marionas01/Global_Resist_Electronics/README.md

This Repo contains the Schematics and PCB files for the electronic components of the EvolChip.
