marionas01/Global_Resist_Electronics/Honeywell_HSC_Pressure_Sensor/production/bom.csv

Designator | Footprint | Quantity | Value | LCSC Part #
C1 | 0603 | 1 | 0.1uF
J1 | Molex_PicoBlade_53048-0410_1x04_P1.25mm_Horizontal | 1 | Conn_01x04
R1, R2 | 0603 | 2 | 10k
SENSOR | Honeywell_HSC_SMT | 1 | Honeywell_HSC_SMT
