marionas01/Global_Resist_Electronics/Control_Board/AO3407A/AO3407A.step

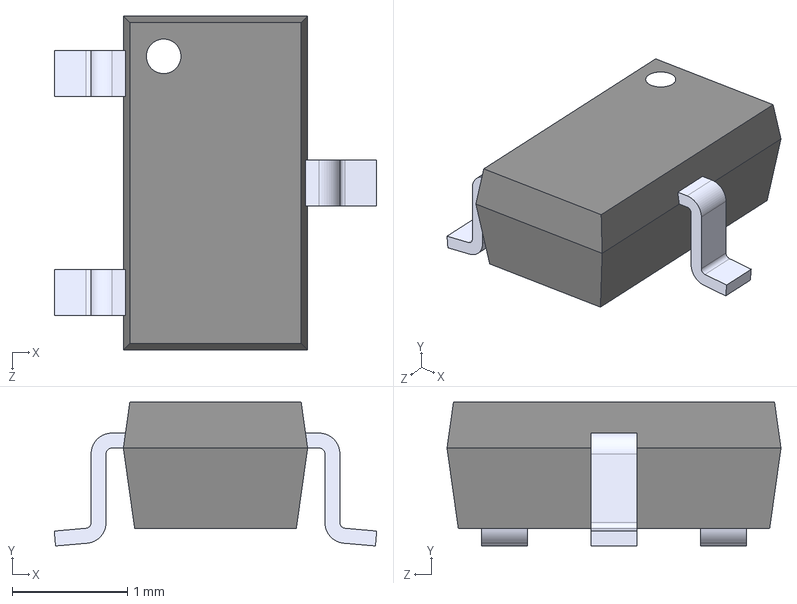
[picture p1: CAD file, 2026-08-07]
Control_Board/AO3407A/AO3407A.step
2.80 x 1.25 x 2.90 mm
