marionas01/Global_Resist_Electronics/Control_Board/CAD/MPU-9250.SLDPRT

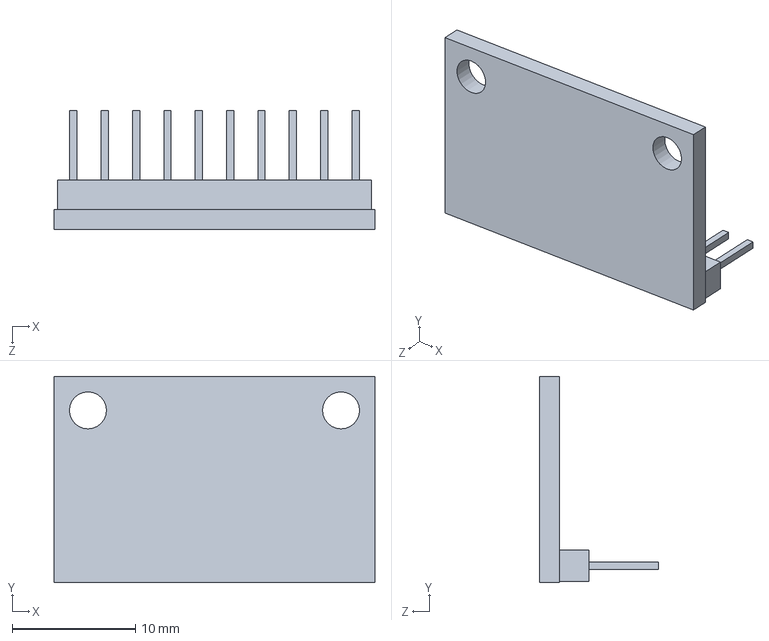
[picture p2: CAD file, 2026-11-11]
Control_Board/CAD/MPU-9250.SLDPRT
26.0 x 16.7 x 9.60 mm
