marionas01/Global_Resist_Electronics/Control_Board/TCA9406DCUR/TCA9406DCUR.step

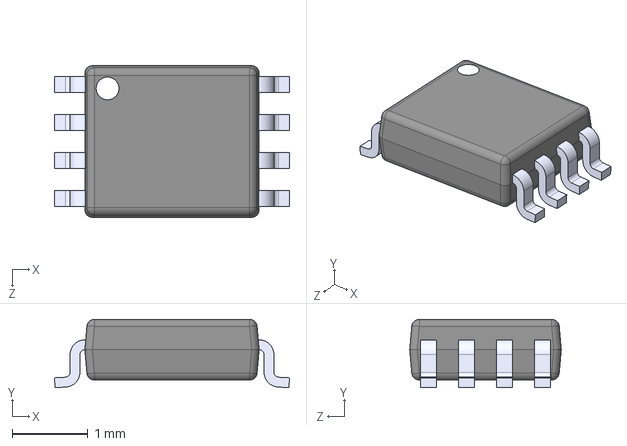
[picture p3: CAD file, 2026-08-07]
Control_Board/TCA9406DCUR/TCA9406DCUR.step
3.10 x 0.9 x 2.00 mm
