marionas01/Global_Resist_Electronics/Control_Board/TL2285EE/TL2285EE.step

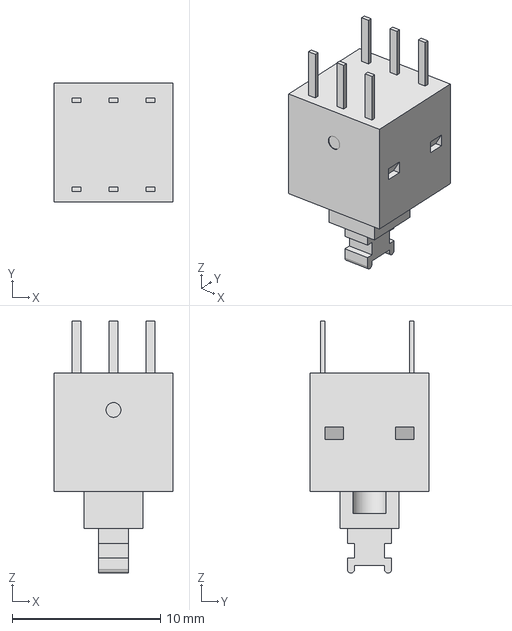
[picture p4: CAD file, 2026-08-07]
Control_Board/TL2285EE/TL2285EE.step
8.00 x 8.00 x 17.0 mm
