marionas01/Global_Resist_Electronics/Control_Board/CAD/Microfluid_Stage.SLDPRT

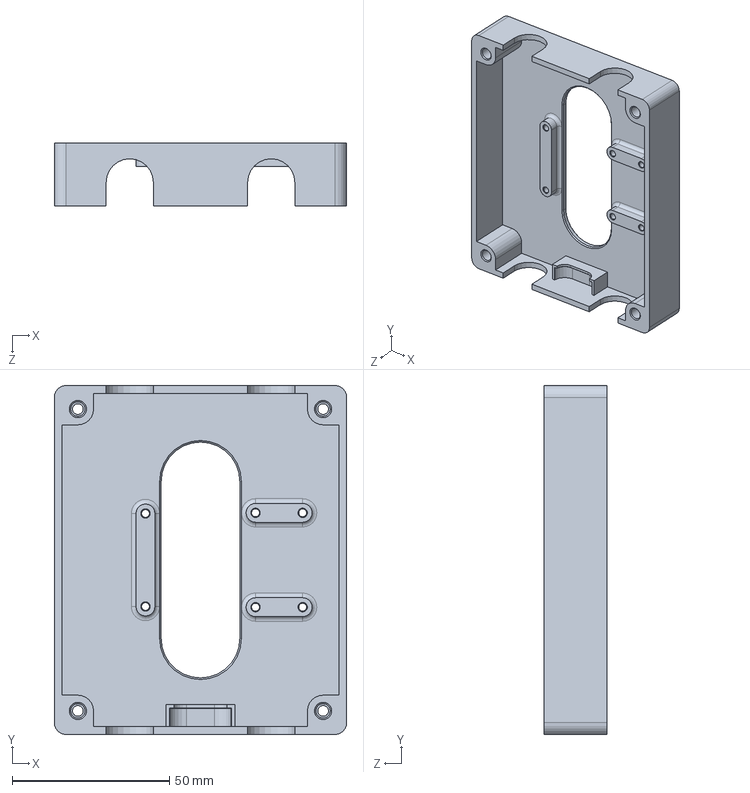
[picture p5: CAD file, 2026-11-11]
Control_Board/CAD/Microfluid_Stage.SLDPRT
93.0 x 111.0 x 20.0 mm
