marionas01/Global_Resist_Electronics/Control_Board/CAD/Case.STEP

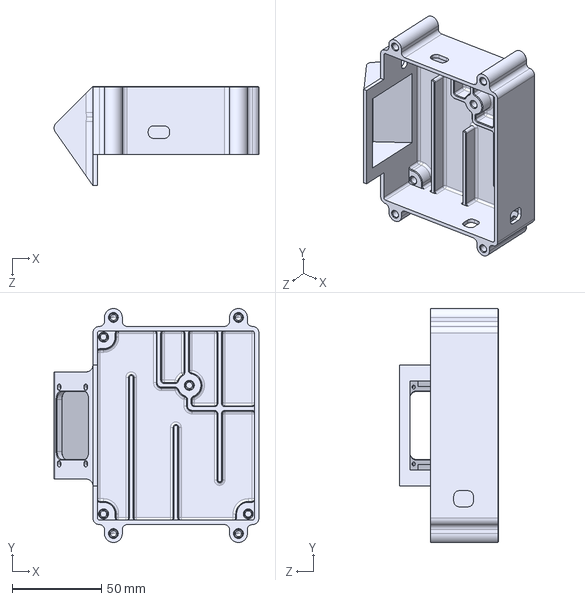
[picture p6: CAD file, 2026-11-11]
Control_Board/CAD/Case.STEP
114.7 x 131.0 x 55.5 mm
