marionas01/Global_Resist_Electronics/Control_Board/CAD/Moisture_Trap_Cap-Perf.STEP

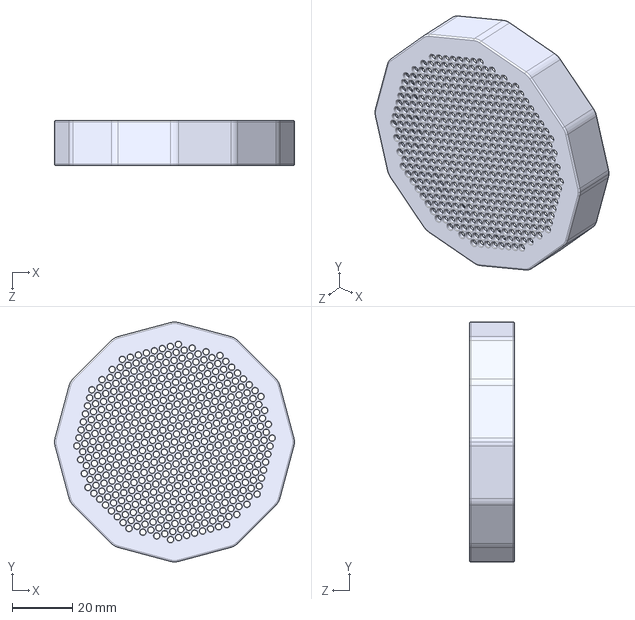
[picture p7: CAD file, 2026-11-11]
Control_Board/CAD/Moisture_Trap_Cap-Perf.STEP
79.6 x 79.6 x 15.0 mm
