marionas01/Global_Resist_Electronics/Control_Board/CAD/Mounting Frame_Rework.STEP

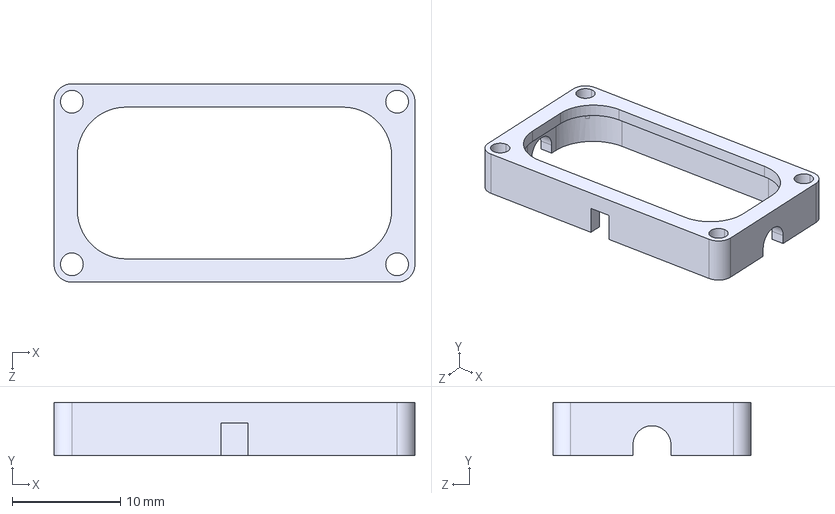
[picture p8: CAD file, 2026-11-11]
Control_Board/CAD/Mounting Frame_Rework.STEP
33.3 x 4.90 x 18.3 mm
