marionas01/Global_Resist_Electronics/Control_Board/CAD/Chip_FDM_04mm-Nozzle.SLDPRT

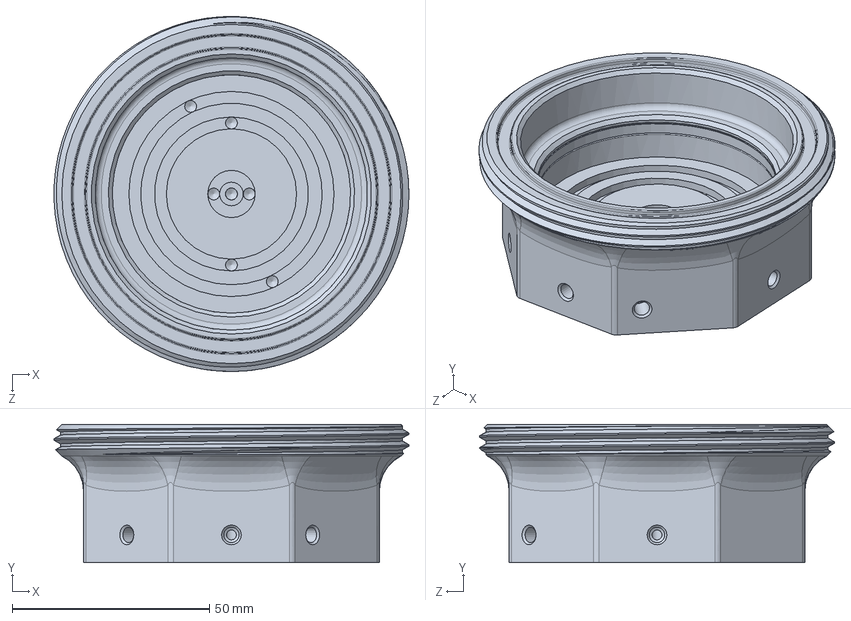
[picture p9: CAD file, 2026-11-11]
Control_Board/CAD/Chip_FDM_04mm-Nozzle.SLDPRT
90.0 x 35.0 x 90.0 mm
