marionas01/Global_Resist_Electronics/Control_Board/CAD/mp-damper 3D model.STEP

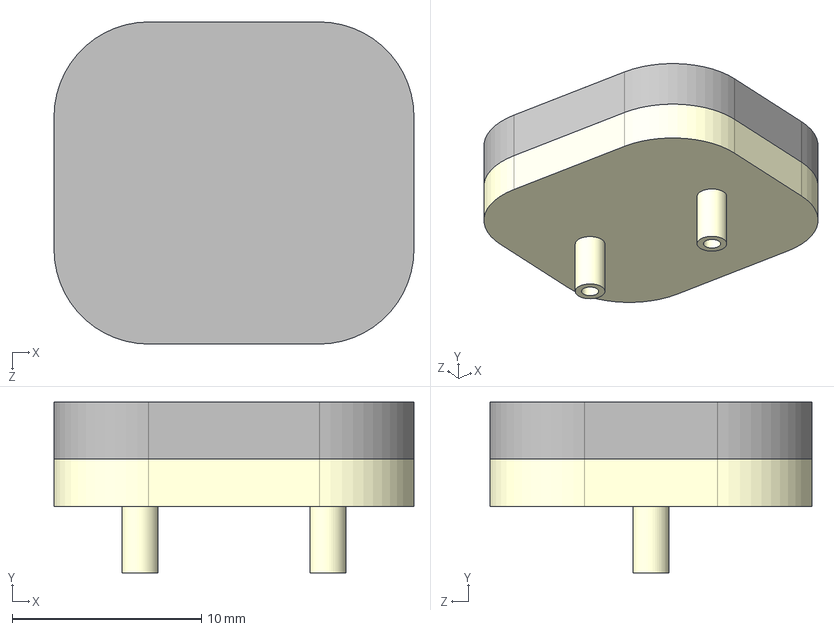
[picture p10: CAD file, 2026-11-11]
Control_Board/CAD/mp-damper 3D model.STEP
19.0 x 9.00 x 17.0 mm
mp-damper_Body
Membran
mp-damper_Deckel
