marionas01/Global_Resist_Electronics/Control_Board/CAD/Mounting Frame_Bottom.SLDPRT

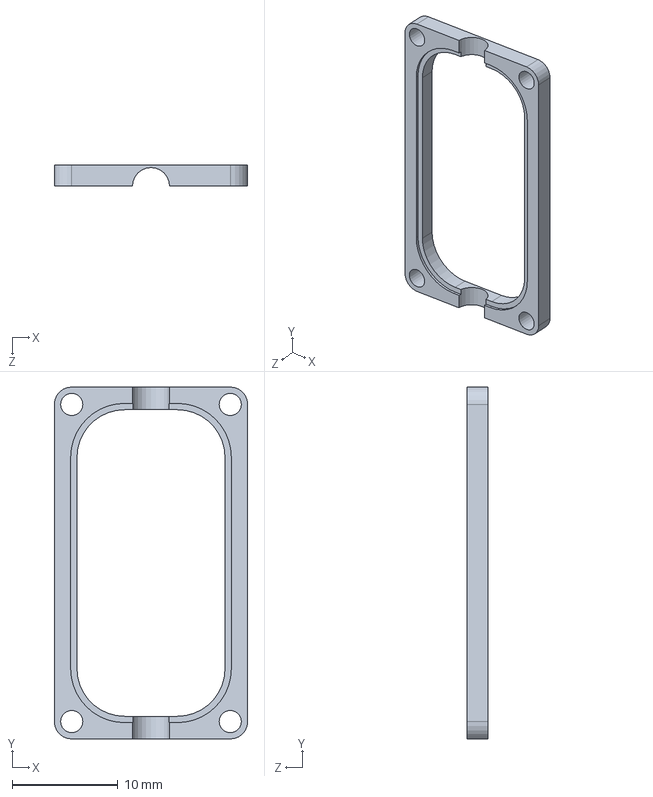
[picture p11: CAD file, 2026-11-11]
Control_Board/CAD/Mounting Frame_Bottom.SLDPRT
18.3 x 33.3 x 2.00 mm
