marionas01/Global_Resist_Electronics/Control_Board/CAD/Top_Cover.SLDPRT

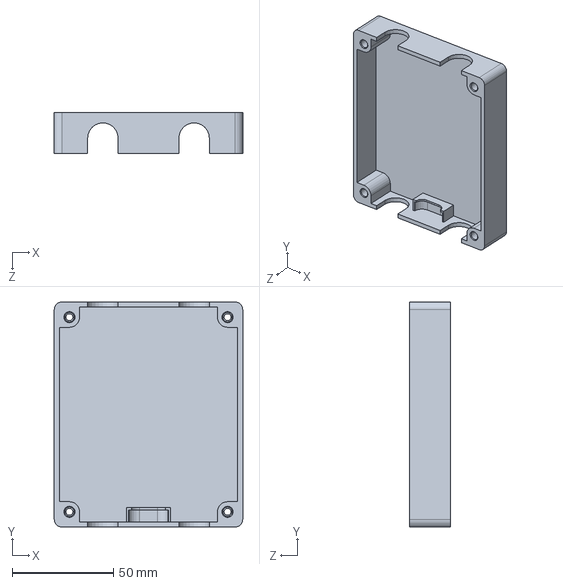
[picture p12: CAD file, 2026-11-11]
Control_Board/CAD/Top_Cover.SLDPRT
93.0 x 111.0 x 20.0 mm
