marionas01/Global_Resist_Electronics/Control_Board/CAD/Cover.STEP

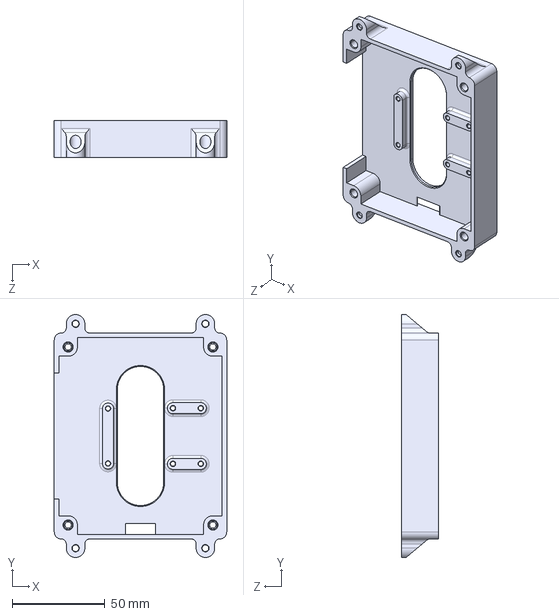
[picture p13: CAD file, 2026-11-11]
Control_Board/CAD/Cover.STEP
93.0 x 131.0 x 20.0 mm
