marionas01/Global_Resist_Electronics/Control_Board/CAD/Moisture_Trap.STEP

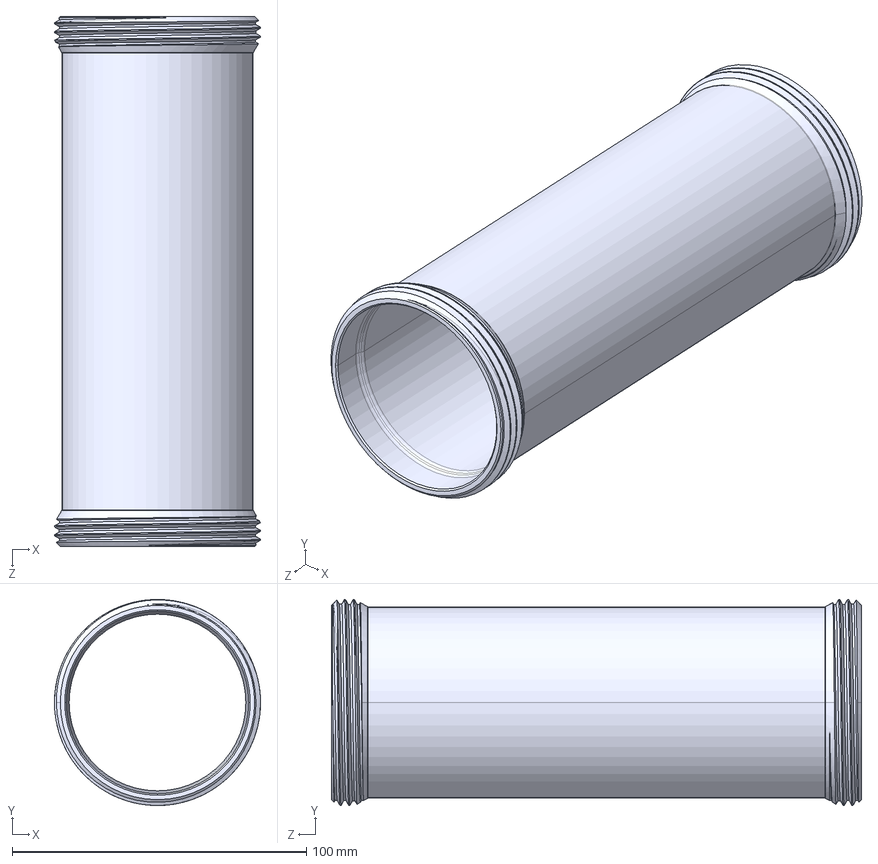
[picture p14: CAD file, 2026-11-11]
Control_Board/CAD/Moisture_Trap.STEP
70.0 x 70.0 x 180.0 mm
