marionas01/Global_Resist_Electronics/Control_Board/CAD/Neviliertisch.STEP

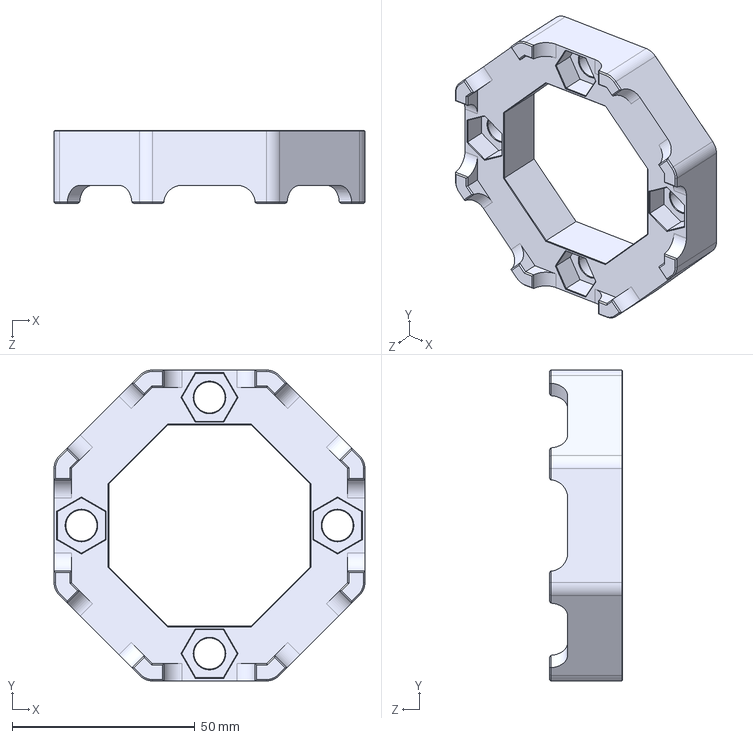
[picture p15: CAD file, 2026-11-11]
Control_Board/CAD/Neviliertisch.STEP
85.0 x 85.0 x 20.0 mm
