marionas01/Global_Resist_Electronics/Control_Board/CAD/Sensirion_Liquid_Flow_Software_SLF3S-1300F_CAD-Model_D1.step

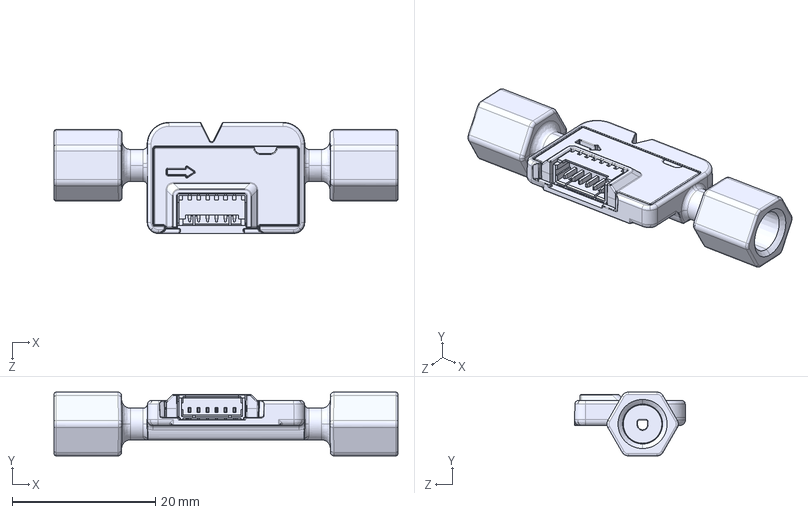
[picture p16: CAD file, 2026-09-17]
Control_Board/CAD/Sensirion_Liquid_Flow_Software_SLF3S-1300F_CAD-Model_D1.step
48.0 x 8.90 x 15.5 mm
