marionas01/Global_Resist_Electronics/Control_Board/CAD/Mounting Frame.STEP

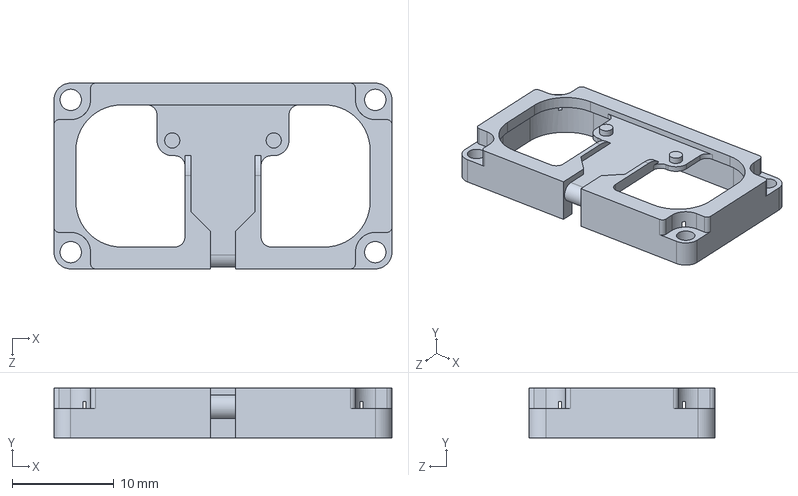
[picture p17: CAD file, 2026-09-17]
Control_Board/CAD/Mounting Frame.STEP
33.3 x 4.90 x 18.3 mm
