marionas01/Global_Resist_Electronics/Control_Board/CAD/PCB.step

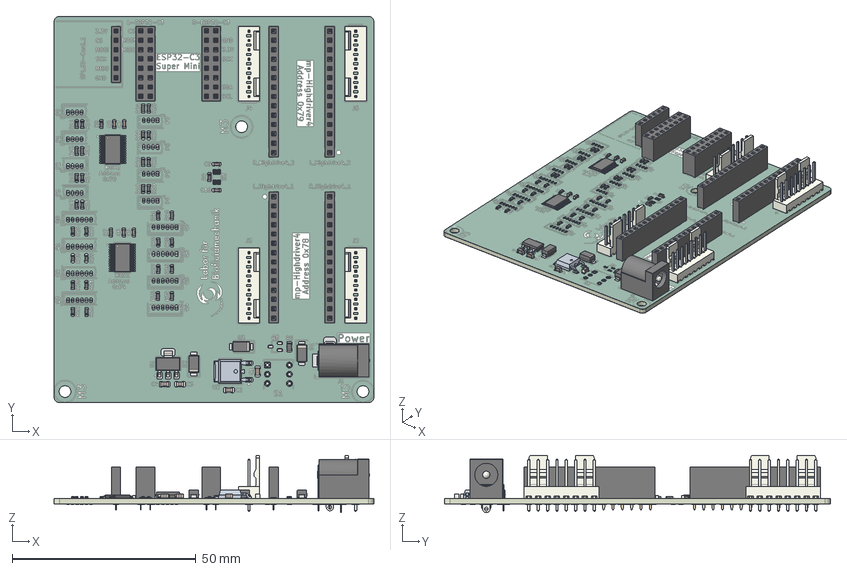
[picture p18: CAD file, 2026-09-17]
Control_Board/CAD/PCB.step
87.0 x 105.0 x 15.6 mm
R_0603_1608Metric x 35
C_0603_1608Metric x 6
PinSocket_1x14_P2.54mm_Vertical x 4
Molex_KK-254_AE-6410-08A_1x08_P2.54mm_Vertical x 4
TSSOP-24_4.4x7.8mm_P0.65mm x 2
BarrelJack_Horizontal
C_0805_2012Metric x 4
PCB 1.44.1
R_0805_2012Metric
SOT-223
D_SMA x 3
PinSocket_2x08_P2.54mm_Vertical x 2
PinSocket_1x06_P2.54mm_Vertical
Control_Board_pad
Control_Board_silkscreen x 2
Control_Board_soldermask x 2
Control_Board_PCB
