marionas01/Global_Resist_Electronics/Control_Board/CAD/The Bartels Pump BP7- Tubing.STEP

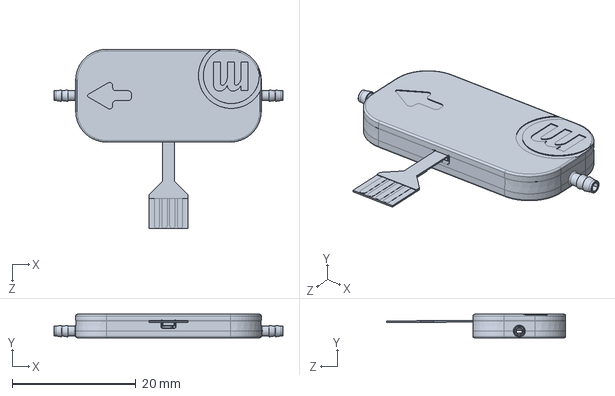
[picture p19: CAD file, 2026-09-17]
Control_Board/CAD/The Bartels Pump BP7- Tubing.STEP
37.0 x 3.80 x 29.0 mm
