marionas01/Global_Resist_Electronics/Control_Board/CAD/SLF3xMountingClamp_3D-CAD.STEP

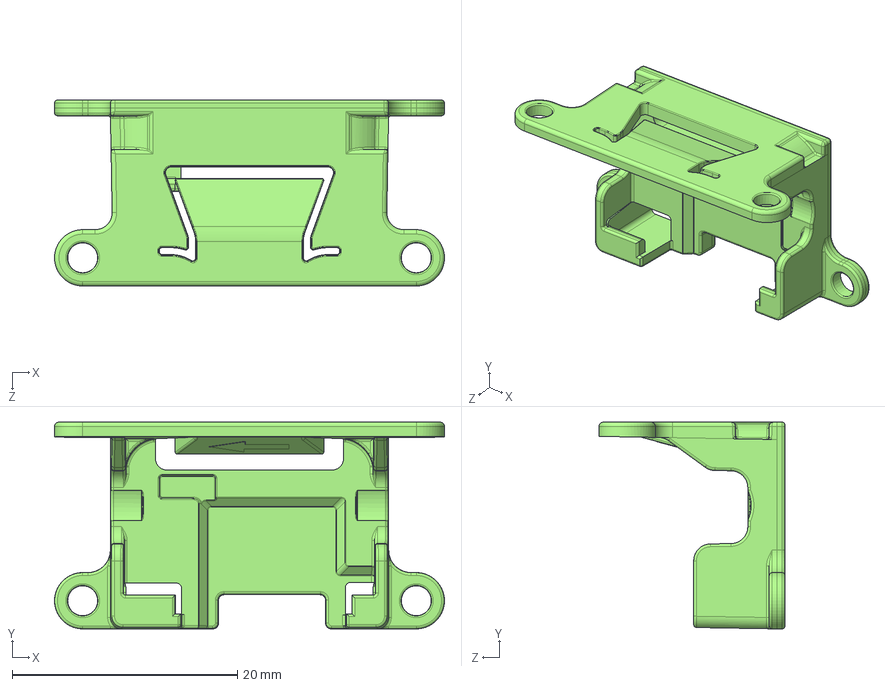
[picture p20: CAD file, 2026-09-17]
Control_Board/CAD/SLF3xMountingClamp_3D-CAD.STEP
34.6 x 18.4 x 16.5 mm
