marionas01/Global_Resist_Electronics/Control_Board/CAD/LCD_Display.SLDPRT

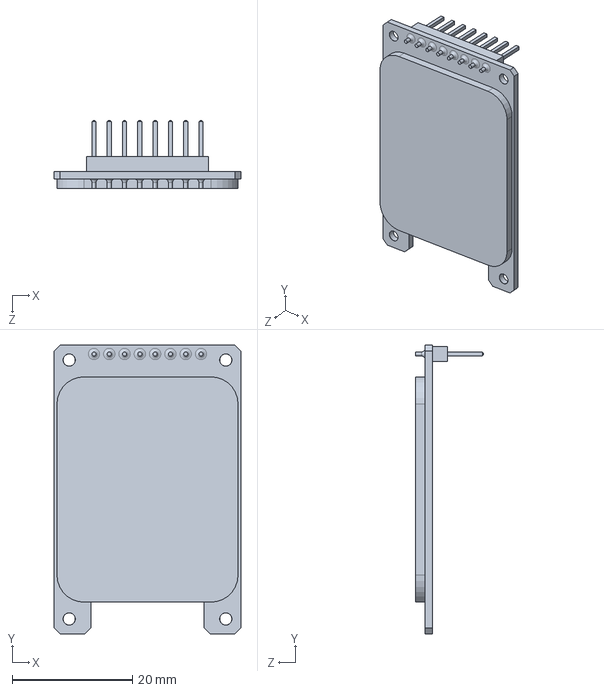
[picture p21: CAD file, 2026-09-08]
Control_Board/CAD/LCD_Display.SLDPRT
31.0 x 48.0 x 11.3 mm
