marionas01/Global_Resist_Electronics/Control_Board/CAD/Display_Cover_Test.STEP

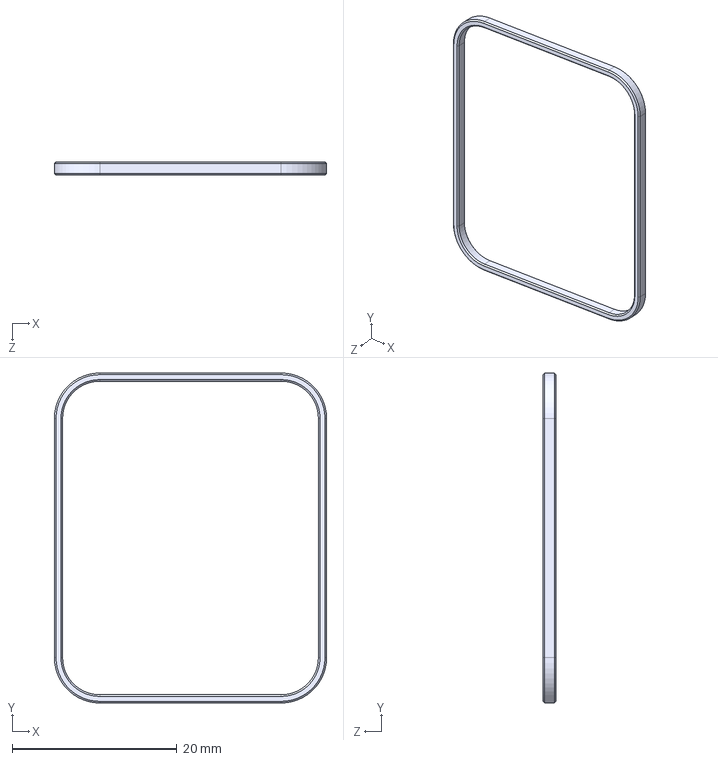
[picture p22: CAD file, 2026-09-08]
Control_Board/CAD/Display_Cover_Test.STEP
33.0 x 40.0 x 1.60 mm
