marionas01/Global_Resist_Electronics/Control_Board/CAD/Mounting_Bracket.STEP

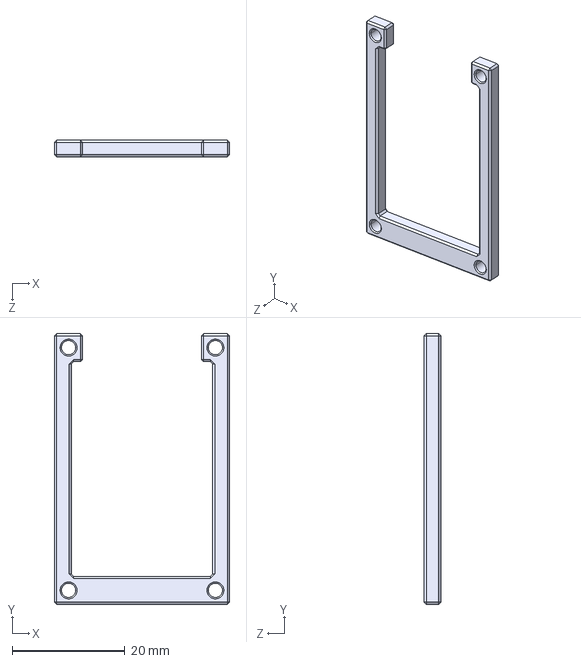
[picture p23: CAD file, 2026-09-08]
Control_Board/CAD/Mounting_Bracket.STEP
31.0 x 48.0 x 3.00 mm
