marionas01/Global_Resist_Electronics/Control_Board/CAD/Asm.SLDASM

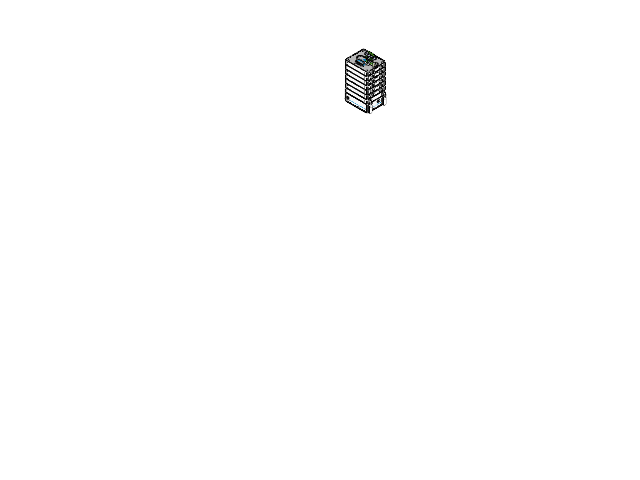
[picture p24: CAD file, 2026-11-11]
Control_Board/CAD/Asm.SLDASM
Case
LCD_Display
Mounting_Bracket
Cover
PCB
Mounting Frame x 7
The Bartels Pump BP7- Tubing x 7
Mounting Frame_Bottom x 7
SLF3xMountingClamp_3D-CAD x 7
Sensirion_Liquid_Flow_Software_SLF3S-1300F_CAD-Model_D1 x 7
Microfluid_Stage x 6
mp-damper_Body.STEP x 6
Membran.STEP x 6
mp-damper_Deckel.STEP x 6
