marionas01/Global_Resist_Electronics/Control_Board/CAD/The Bartels Pump BP7_Mounting Frame_Asm.SLDASM

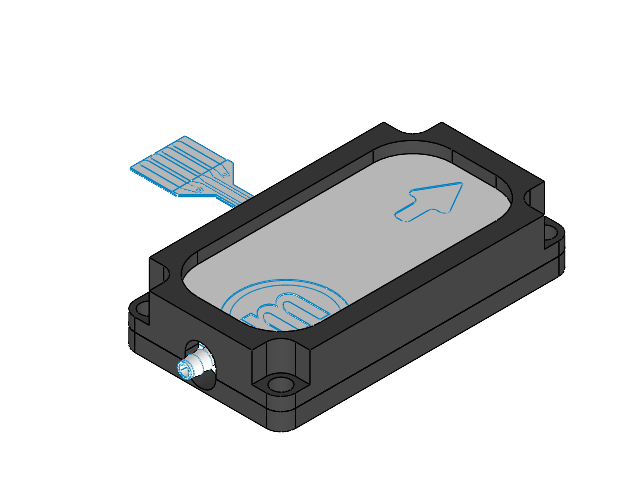
[picture p25: CAD file, 2026-11-11]
Control_Board/CAD/The Bartels Pump BP7_Mounting Frame_Asm.SLDASM
Mounting Frame
The Bartels Pump BP7- Tubing
Mounting Frame_Bottom
