marionas01/Global_Resist_Electronics/Control_Board/CAD/Neviliertisch_Asm.SLDASM

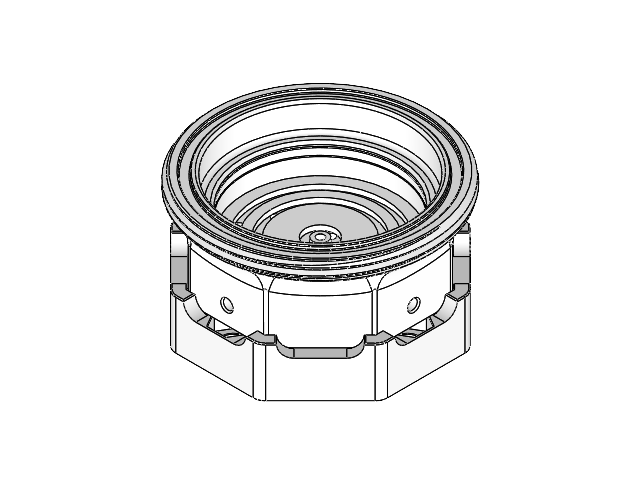
[picture p26: CAD file, 2026-11-11]
Control_Board/CAD/Neviliertisch_Asm.SLDASM
Neviliertisch
Chip_FDM_04mm-Nozzle
