marionas01/Global_Resist_Electronics/Control_Board/CAD/SLF3x_Asm.SLDASM

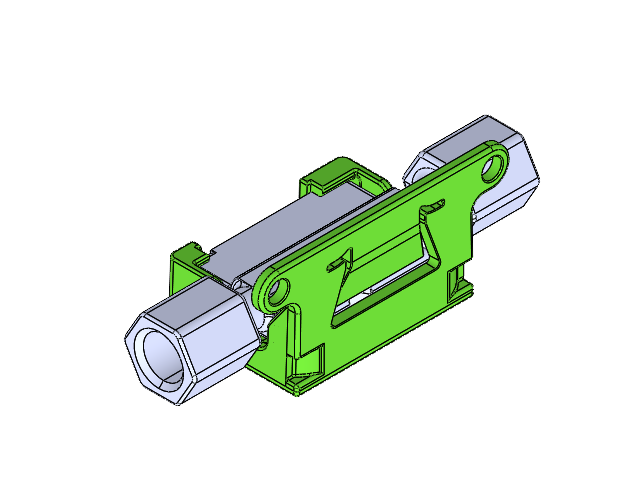
[picture p27: CAD file, 2026-11-11]
Control_Board/CAD/SLF3x_Asm.SLDASM
SLF3xMountingClamp_3D-CAD
Sensirion_Liquid_Flow_Software_SLF3S-1300F_CAD-Model_D1
