marionas01/Global_Resist_Electronics/Control_Board/CAD/Microfluid_Stage_Asm.SLDASM

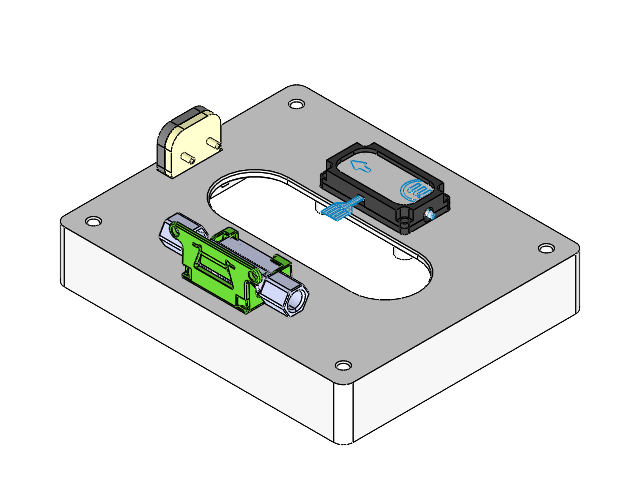
[picture p28: CAD file, 2026-11-11]
Control_Board/CAD/Microfluid_Stage_Asm.SLDASM
Microfluid_Stage
mp-damper_Body.STEP
Membran.STEP
mp-damper_Deckel.STEP
SLF3xMountingClamp_3D-CAD
Sensirion_Liquid_Flow_Software_SLF3S-1300F_CAD-Model_D1
Mounting Frame
The Bartels Pump BP7- Tubing
Mounting Frame_Bottom
