marionas01/Global_Resist_Electronics/(list of files, cad)

Other CAD files:
Control_Board/CAD/Moisture_Trap_Cap.STEP
Control_Board/CAD/Case.SLDPRT
Control_Board/CAD/Cover.SLDPRT
Control_Board/CAD/Display_Cover_Test.SLDPRT
Control_Board/CAD/Moisture_Trap.SLDPRT
Control_Board/CAD/Moisture_Trap_Cap-Perf.SLDPRT
Control_Board/CAD/Moisture_Trap_Cap.SLDPRT
Control_Board/CAD/Mounting Frame.SLDPRT
Control_Board/CAD/Mounting_Bracket.SLDPRT
Control_Board/CAD/Neviliertisch.SLDPRT
Control_Board/CAD/PCB.SLDPRT
Control_Board/CAD/SLF3xMountingClamp_3D-CAD.SLDPRT
Control_Board/CAD/Sensirion_Liquid_Flow_Software_SLF3S-1300F_CAD-Model_D1.SLDPRT
Control_Board/CAD/The Bartels Pump BP7- Tubing.SLDPRT
Control_Board/CAD/mp-damper 3D model.SLDASM
