marionas01/Global_Resist_Electronics/Flowsensor_Calibration/Flowsensor_Vergleich.xlsx

Sheet: Vergleich
Vergleich manuelle Messung (Waage) vs. Flowsensor (Plateau-Mittelwerte)
Manuell: MW/min [ml] aus Tabelle1 Zeile 10 (Formel unverändert übernommen), umgerechnet ×1000 in µl/min. Sensor: Plateau-MW aus Blatt "Plateaus".
Kanal | Datei | Soll-Flussrate [µl/min] | Manuell MW/min [ml/min] | Manuell [µl/min] | Sensor Plateau-MW [µl/min] | Sensor Std-Abw. [µl/min] | Abweichung Sensor − Manuell [µl/min] | Rel. Abweichung [%] | Faktor Manuell/Sensor
Channel 1 | #027 | 250 | 0.2433 | 243.3 | 229.8 | 7.0 | -+13.4 | -+5.5% | 1.058
Channel 1 | #027 | 500 | 0.4825 | 482.5 | 445.7 | 14.2 | -+36.8 | -+7.6% | 1.083
Channel 1 | #027 | 750 | 0.7178 | 717.8 | 645.3 | 17.0 | -+72.5 | -+10.1% | 1.112
Channel 1 | #027 | 1000 | 0.9771 | 977.1 | 839.3 | 19.7 | -+137.8 | -+14.1% | 1.164
Channel 1 | #027 | 2000 | 1.9920 | 1992.0 | 1048.4 | 110.0 | -+943.6 | -+47.4% | 1.900
Channel 2 | #028 | 250 | 0.2331 | 233.1 | 250.3 | 9.6 | +17.2 | +7.4% | 0.931
Channel 2 | #028 | 500 | 0.4843 | 484.3 | 494.6 | 9.4 | +10.3 | +2.1% | 0.979
Channel 2 | #028 | 750 | 0.7372 | 737.2 | 756.5 | 15.8 | +19.3 | +2.6% | 0.974
Channel 2 | #028 | 1000 | 0.9890 | 989.0 | 1009.4 | 18.0 | +20.4 | +2.1% | 0.980
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
