marionas01/Global_Resist_Electronics/Flowsensor_Calibration/Flowsensor_Kalibrierung.xlsx

Channel: 0 | V-Flow [ul/min] |  |  |  |  |  |  | Channel: 1 | V-Flow [ul/min] |  |  |  |  |  |  | Channel: 2 | V-Flow [ul/min] |  |  |  |  |  |  | Channel: 3 | V-Flow [ul/min] |  |  |  |  |  |  | Channel: 4 | V-Flow [ul/min] |  |  |  |  |  |  | Channel: 5 | V-Flow [ul/min] |  |  |  |  |  |  | Channel: 6 | V-Flow [ul/min] |  |  |  |  |  |  | Channel: 7 | V-Flow [ul/min]
Zeit [min] | 0 | 250 | 500 | 750 | 1000 | 2000 |  | Zeit [min] | 0 | 250 | 500 | 750 | 1000 | 2000 |  | Zeit [min] | 0 | 250 | 500 | 750 | 1000 | 1500 |  | Zeit [min] | 0 | 250 | 500 | 750 | 1000 | 2000 |  | Zeit [min] | 0 | 250 | 500 | 750 | 1000 | 2000 |  | Zeit [min] | 0 | 250 | 500 | 750 | 1000 | 2000 |  | Zeit [min] | 0 | 250 | 500 | 750 | 1000 | 2000 |  | Zeit [min] | 0 | 250 | 500
0 |  |  |  |  |  |  |  | 0 | 0 | 0.02 | 1.24 | 3.7 | 7.4 | 12.36 |  | 0 | 0 | 0 | 1.181 | 3.633 | 7.36 | 12.38 |  | 0 | 0 | 0 | 1.196 | 3.67 | 7.4 | 12.37 |  | 0 | 0 | 0 | 1.21 | 3.68 | 7.42 | 12.39 |  | 0 | 0 | 0 | 1.22 | 3.7 | 7.41 | 0 |  | 0 | 0 | 0 | 1.22 | 3.71 | 7.43 | 12.42 |  | 0 | 0 | 0 | 1.16
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
