marionas01/Global_Resist_Electronics/Flowsensor_Calibration/Daten/flowlog_027.csv

millis_ms | ch1_flow_mean_ulmin | ch1_flow_min_ulmin | ch1_flow_max_ulmin | ch1_temp_C | ch1_n | ch1_air | ch1_hiflow | ch2_flow_mean_ulmin | ch2_flow_min_ulmin | ch2_flow_max_ulmin | ch2_temp_C | ch2_n | ch2_air | ch2_hiflow | ch3_flow_mean_ulmin | ch3_flow_min_ulmin | ch3_flow_max_ulmin | ch3_temp_C | ch3_n | ch3_air | ch3_hiflow | ch4_flow_mean_ulmin | ch4_flow_min_ulmin | ch4_flow_max_ulmin | ch4_temp_C | ch4_n | ch4_air | ch4_hiflow | ch5_flow_mean_ulmin | ch5_flow_min_ulmin | ch5_flow_max_ulmin | ch5_temp_C | ch5_n | ch5_air | ch5_hiflow | ch6_flow_mean_ulmin | ch6_flow_min_ulmin | ch6_flow_max_ulmin | ch6_temp_C | ch6_n | ch6_air | ch6_hiflow | ch7_flow_mean_ulmin | ch7_flow_min_ulmin | ch7_flow_max_ulmin | ch7_temp_C | ch7_n | ch7_air | ch7_hiflow
6462 | 2.49 | 0.50 | 4.70 | 27.41 | 20 | 0 | 0 | -0.09 | -0.10 | 0.00 | 27.55 | 20 | 20 | 0 | 0.30 | 0.30 | 0.30 | 27.12 | 20 | 20 | 0 | 0.80 | 0.50 | 1.60 | 27.61 | 20 | 20 | 0 | 0.07 | -0.10 | 0.10 | 27.34 | 20 | 20 | 0 | 2.30 | 1.20 | 3.30 | 27.62 | 20 | 20 | 0 | 0.19 | 0.10 | 0.20 | 26.68 | 20 | 20 | 0
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
