marionas01/Global_Resist_Electronics/Flowsensor_Calibration/Daten/flowlog_029.csv

millis_ms | ch1_flow_mean_ulmin | ch1_flow_min_ulmin | ch1_flow_max_ulmin | ch1_temp_C | ch1_n | ch1_air | ch1_hiflow | ch2_flow_mean_ulmin | ch2_flow_min_ulmin | ch2_flow_max_ulmin | ch2_temp_C | ch2_n | ch2_air | ch2_hiflow | ch3_flow_mean_ulmin | ch3_flow_min_ulmin | ch3_flow_max_ulmin | ch3_temp_C | ch3_n | ch3_air | ch3_hiflow | ch4_flow_mean_ulmin | ch4_flow_min_ulmin | ch4_flow_max_ulmin | ch4_temp_C | ch4_n | ch4_air | ch4_hiflow | ch5_flow_mean_ulmin | ch5_flow_min_ulmin | ch5_flow_max_ulmin | ch5_temp_C | ch5_n | ch5_air | ch5_hiflow | ch6_flow_mean_ulmin | ch6_flow_min_ulmin | ch6_flow_max_ulmin | ch6_temp_C | ch6_n | ch6_air | ch6_hiflow | ch7_flow_mean_ulmin | ch7_flow_min_ulmin | ch7_flow_max_ulmin | ch7_temp_C | ch7_n | ch7_air | ch7_hiflow
6507 | 0.34 | 0.10 | 1.00 | 24.29 | 20 | 20 | 0 | 3.34 | 1.90 | 4.60 | 24.19 | 20 | 20 | 0 | -0.96 | -1.40 | -0.40 | 23.37 | 20 | 0 | 0 | 1.50 | 0.90 | 2.30 | 23.80 | 20 | 20 | 0 | 0.15 | 0.10 | 0.20 | 23.90 | 20 | 20 | 0 | 0.88 | 0.60 | 1.10 | 24.13 | 20 | 20 | 0 | 0.23 | 0.20 | 0.30 | 23.26 | 20 | 20 | 0
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
