marionas01/Global_Resist_Electronics/Flowsensor_Calibration/Daten/flowlog_031.csv

millis_ms | ch1_flow_mean_ulmin | ch1_flow_min_ulmin | ch1_flow_max_ulmin | ch1_temp_C | ch1_n | ch1_air | ch1_hiflow | ch2_flow_mean_ulmin | ch2_flow_min_ulmin | ch2_flow_max_ulmin | ch2_temp_C | ch2_n | ch2_air | ch2_hiflow | ch3_flow_mean_ulmin | ch3_flow_min_ulmin | ch3_flow_max_ulmin | ch3_temp_C | ch3_n | ch3_air | ch3_hiflow | ch4_flow_mean_ulmin | ch4_flow_min_ulmin | ch4_flow_max_ulmin | ch4_temp_C | ch4_n | ch4_air | ch4_hiflow | ch5_flow_mean_ulmin | ch5_flow_min_ulmin | ch5_flow_max_ulmin | ch5_temp_C | ch5_n | ch5_air | ch5_hiflow | ch6_flow_mean_ulmin | ch6_flow_min_ulmin | ch6_flow_max_ulmin | ch6_temp_C | ch6_n | ch6_air | ch6_hiflow | ch7_flow_mean_ulmin | ch7_flow_min_ulmin | ch7_flow_max_ulmin | ch7_temp_C | ch7_n | ch7_air | ch7_hiflow
6555 | 0.10 | -0.70 | 0.40 | 24.91 | 20 | 20 | 0 | 0.02 | -0.10 | 0.10 | 24.62 | 20 | 20 | 0 | -10.08 | -11.20 | -7.30 | 24.79 | 20 | 20 | 0 | 4.30 | 3.10 | 5.40 | 24.08 | 20 | 0 | 0 | 0.13 | 0.10 | 0.20 | 24.67 | 20 | 20 | 0 | 1.39 | 1.10 | 1.70 | 24.60 | 20 | 20 | 0 | 0.22 | 0.20 | 0.30 | 23.93 | 20 | 20 | 0
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
