marionas01/Global_Resist_Electronics/Flowsensor_Calibration/Daten/flowlog_032.csv

millis_ms | ch1_flow_mean_ulmin | ch1_flow_min_ulmin | ch1_flow_max_ulmin | ch1_temp_C | ch1_n | ch1_air | ch1_hiflow | ch2_flow_mean_ulmin | ch2_flow_min_ulmin | ch2_flow_max_ulmin | ch2_temp_C | ch2_n | ch2_air | ch2_hiflow | ch3_flow_mean_ulmin | ch3_flow_min_ulmin | ch3_flow_max_ulmin | ch3_temp_C | ch3_n | ch3_air | ch3_hiflow | ch4_flow_mean_ulmin | ch4_flow_min_ulmin | ch4_flow_max_ulmin | ch4_temp_C | ch4_n | ch4_air | ch4_hiflow | ch5_flow_mean_ulmin | ch5_flow_min_ulmin | ch5_flow_max_ulmin | ch5_temp_C | ch5_n | ch5_air | ch5_hiflow | ch6_flow_mean_ulmin | ch6_flow_min_ulmin | ch6_flow_max_ulmin | ch6_temp_C | ch6_n | ch6_air | ch6_hiflow | ch7_flow_mean_ulmin | ch7_flow_min_ulmin | ch7_flow_max_ulmin | ch7_temp_C | ch7_n | ch7_air | ch7_hiflow
6578 | 0.35 | 0.30 | 0.40 | 24.32 | 20 | 20 | 0 | 0.01 | -0.10 | 0.10 | 23.48 | 20 | 20 | 0 | -0.22 | -0.30 | -0.10 | 23.57 | 20 | 20 | 0 | 0.80 | 0.70 | 0.90 | 23.40 | 20 | 20 | 0 | 0.64 | -1.70 | 3.10 | 23.35 | 20 | 0 | 0 | 1.37 | 1.00 | 1.70 | 23.40 | 20 | 20 | 0 | 0.22 | 0.20 | 0.30 | 22.88 | 20 | 20 | 0
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
