marionas01/Global_Resist_Electronics/Flowsensor_Calibration/Daten/flowlog_034.csv

millis_ms | ch1_flow_mean_ulmin | ch1_flow_min_ulmin | ch1_flow_max_ulmin | ch1_temp_C | ch1_n | ch1_air | ch1_hiflow | ch2_flow_mean_ulmin | ch2_flow_min_ulmin | ch2_flow_max_ulmin | ch2_temp_C | ch2_n | ch2_air | ch2_hiflow | ch3_flow_mean_ulmin | ch3_flow_min_ulmin | ch3_flow_max_ulmin | ch3_temp_C | ch3_n | ch3_air | ch3_hiflow | ch4_flow_mean_ulmin | ch4_flow_min_ulmin | ch4_flow_max_ulmin | ch4_temp_C | ch4_n | ch4_air | ch4_hiflow | ch5_flow_mean_ulmin | ch5_flow_min_ulmin | ch5_flow_max_ulmin | ch5_temp_C | ch5_n | ch5_air | ch5_hiflow | ch6_flow_mean_ulmin | ch6_flow_min_ulmin | ch6_flow_max_ulmin | ch6_temp_C | ch6_n | ch6_air | ch6_hiflow | ch7_flow_mean_ulmin | ch7_flow_min_ulmin | ch7_flow_max_ulmin | ch7_temp_C | ch7_n | ch7_air | ch7_hiflow
6623 | 0.30 | 0.30 | 0.30 | 26.69 | 20 | 20 | 0 | 0.01 | -0.10 | 0.10 | 25.42 | 20 | 20 | 0 | 0.34 | 0.30 | 0.40 | 25.31 | 20 | 20 | 0 | 0.79 | 0.70 | 0.80 | 25.18 | 20 | 20 | 0 | 0.49 | 0.20 | 0.90 | 25.60 | 20 | 20 | 0 | 0.70 | 0.00 | 1.40 | 25.42 | 20 | 0 | 0 | 0.20 | 0.10 | 0.30 | 25.01 | 20 | 20 | 0
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
