marionas01/Global_Resist_Electronics/Flowsensor_Calibration/Boxplot_manuell_Kanalabweichung.png

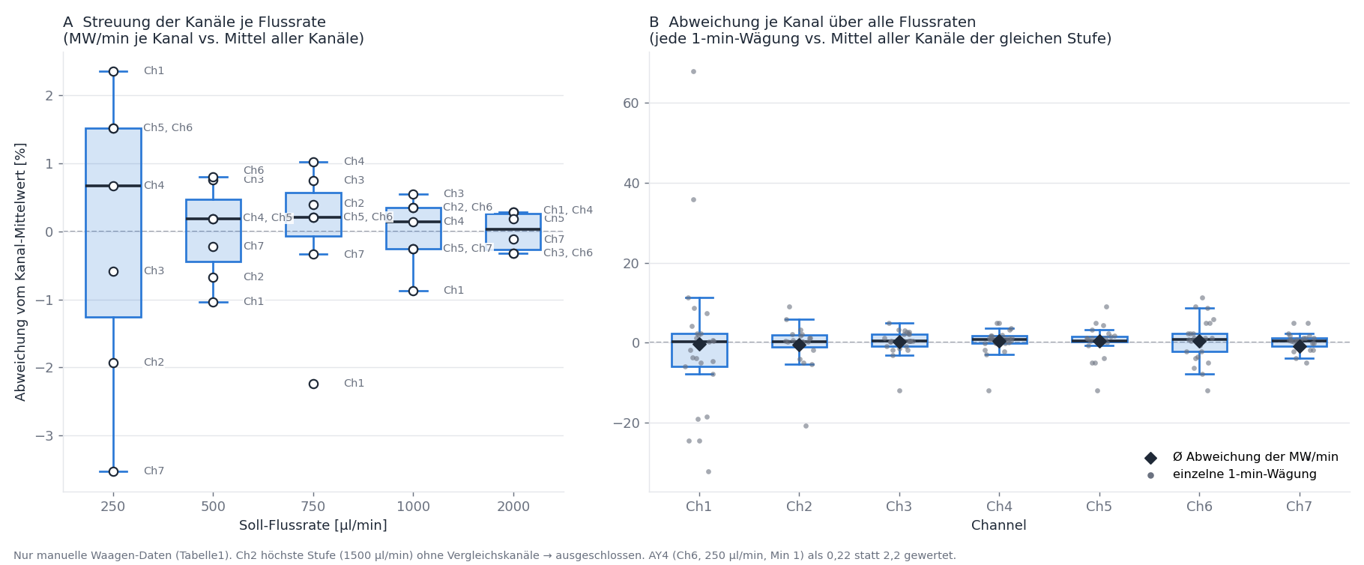
Flowsensor_Calibration/Boxplot_manuell_Kanalabweichung.png
