marionas01/Global_Resist_Electronics/Control_Board/Control_Board.kicad_pcb

## KiCad design Control_Board/Control_Board.kicad_pcb (2026-09-08)

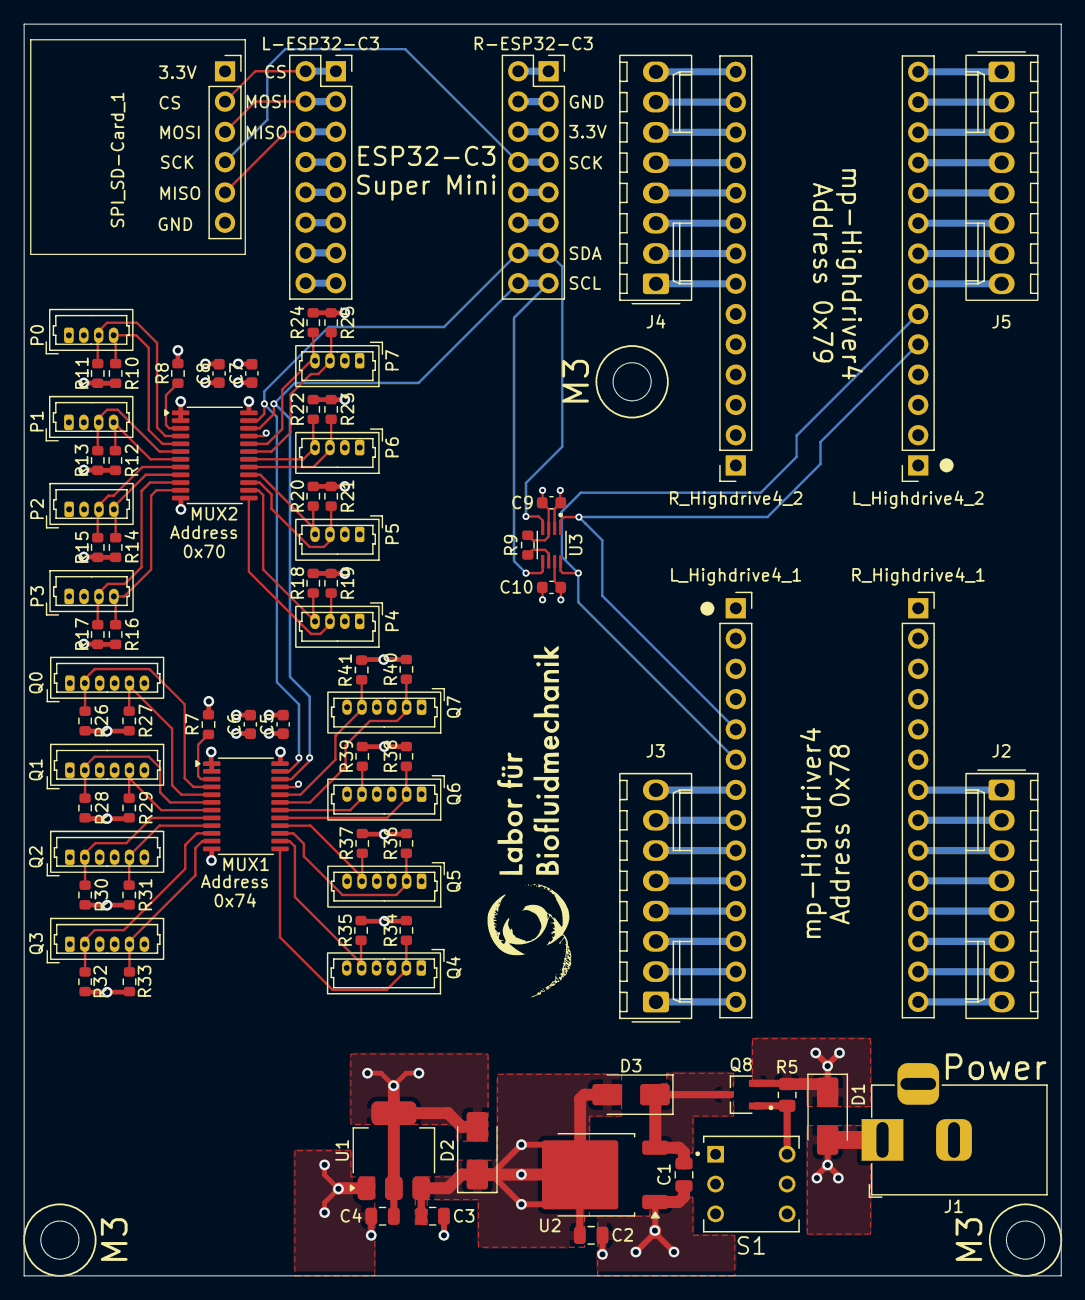
[picture p30: board Control_Board.kicad_pcb from above]

Board: 4 copper layers, 87.0 x 105.0 mm, 84 parts (0 on the bottom side), 82 nets.

Parts:
C1: 10uF; C_0805_2012Metric
C2: 22uF; C_0805_2012Metric
C3: 1uF; C_0805_2012Metric
C4: 2.2uF; C_0805_2012Metric
C5, C7, C9, C10: 0.1uF; C_0603_1608Metric
C6, C8: 1uF; C_0603_1608Metric
D1, D2, D3: B340A; D_SMA
J1: Barrel_Jack_Switch; BarrelJack_Horizontal
J2, J3, J4, J5: C2982037; Molex_KK-254_AE-6410-08A_1x08_P2.54mm_Vertical
L-ESP32-C3: C30734; PinSocket_2x08_P2.54mm_Vertical
L_Highdrive4_1, L_Highdrive4_2: C2905420; PinSocket_1x14_P2.54mm_Vertical
MUX1, MUX2: TCA9548APWR; TSSOP-24_4.4x7.8mm_P0.65mm
P0, P1, P2, P3, P4, P5, P6, P7: MOLEX 530470410; Molex_PicoBlade_53047-0410_1x04_P1.25mm_Vertical
Q0, Q1, Q2, Q3, Q4, Q5, Q6, Q7: MOLEX 530470610; Molex_PicoBlade_53047-0610_1x06_P1.25mm_Vertical
Q8: AO3407A; SOT95P280X125-3N
R5: 10k; R_0805_2012Metric
R7, R8, R10, R11, R12, R13, R14, R15, R16, R17, R18, R19, R20, R21, R22, R23, R24, R25, R26, R27, R28, R29, R30, R31, R32, R33, R34, R35, R36, R37, R38, R39, R40, R41: 4.7k; R_0603_1608Metric
R9: 10k; R_0603_1608Metric
R-ESP32-C3: C30734; PinSocket_2x08_P2.54mm_Vertical
R_Highdrive4_1, R_Highdrive4_2: C2905420; PinSocket_1x14_P2.54mm_Vertical
S1: TL2285EE; SW_TL2285EE
SPI_SD-Card_1: Conn_01x06; PinSocket_1x06_P2.54mm_Vertical
U1: TLV76133DCY; SOT-223-3_TabPin2
U2: AZ1084CD-5.0TRG1; TO-252-2
U3: TCA9406DCUR; SOP50P310X90-8N

Connections:
+3.3V: C4.1, C5.1, C6.1, C7.1, C8.1, C9.1, D2.2 (A), MUX1.21 (A2), MUX1.24 (VCC), MUX2.24 (VCC), P0.2, P1.2, P2.2, P3.2, P4.2, P5.2, P6.2, P7.2, Q0.3, Q1.3, Q2.3, Q3.3, Q4.3, Q5.3, Q6.3, Q7.3, R7.2, R8.2, R9.1, R10.2, R11.2, R12.2, R13.2, R14.2, R15.2, R16.2, R17.2, R18.2, R19.2, R20.2, R21.2, R22.2, R23.2, R24.2, R25.2, R26.2, R27.2, R28.2, R29.2, R30.2, R31.2, R32.2, R33.2, R34.2, R35.2, R36.2, R37.2, R38.2, R39.2, R40.2, R41.2, R-ESP32-C3.5, R-ESP32-C3.6, SPI_SD-Card_1.1, U1.2 (VO), U3.3 (VCCA)
+5V: C2.1, C3.1, C10.1, D2.1 (K), D3.2 (A), L_Highdrive4_1.2, L_Highdrive4_2.2, L_Highdrive4_2.3, R_Highdrive4_1.1, R_Highdrive4_2.1, U1.3 (VI), U2.2 (VO), U3.7 (VCCB)
+9V: D1.1 (K), Q8.2, R5.2
/CS: L-ESP32-C3.1, L-ESP32-C3.2, SPI_SD-Card_1.2
/MISO: L-ESP32-C3.5, L-ESP32-C3.6, SPI_SD-Card_1.5
/MOSI: L-ESP32-C3.3, L-ESP32-C3.4, SPI_SD-Card_1.3
/PIEZO11+_1: J2.7, R_Highdrive4_1.13
/PIEZO11+_2: J4.7, R_Highdrive4_2.13
/PIEZO11-_1: J2.8, R_Highdrive4_1.14
/PIEZO11-_2: J4.8, R_Highdrive4_2.14
/PIEZO12+_1: J2.6, R_Highdrive4_1.12
/PIEZO12+_2: J4.6, R_Highdrive4_2.12
/PIEZO12-_1: J2.5, R_Highdrive4_1.11
/PIEZO12-_2: J4.5, R_Highdrive4_2.11
/PIEZO21+_1: J2.3, R_Highdrive4_1.9
/PIEZO21+_2: J4.3, R_Highdrive4_2.9
/PIEZO21-_1: J2.4, R_Highdrive4_1.10
/PIEZO21-_2: J4.4, R_Highdrive4_2.10
/PIEZO22+_1: J2.2, R_Highdrive4_1.8
/PIEZO22+_2: J4.2, R_Highdrive4_2.8
/PIEZO22-_1: J2.1, R_Highdrive4_1.7
/PIEZO22-_2: J4.1, R_Highdrive4_2.7
/PIEZO31+_1: J3.7, L_Highdrive4_1.8
/PIEZO31+_2: J5.7, L_Highdrive4_2.8
/PIEZO31-_1: J3.8, L_Highdrive4_1.7
/PIEZO31-_2: J5.8, L_Highdrive4_2.7
/PIEZO32+_1: J3.6, L_Highdrive4_1.9
/PIEZO32+_2: J5.6, L_Highdrive4_2.9
/PIEZO32-_1: J3.5, L_Highdrive4_1.10
/PIEZO32-_2: J5.5, L_Highdrive4_2.10
/PIEZO41+_1: J3.3, L_Highdrive4_1.12
/PIEZO41+_2: J5.3, L_Highdrive4_2.12
/PIEZO41-_1: J3.4, L_Highdrive4_1.11
/PIEZO41-_2: J5.4, L_Highdrive4_2.11
/PIEZO42+_1: J3.2, L_Highdrive4_1.13
/PIEZO42+_2: J5.2, L_Highdrive4_2.13
/PIEZO42-_1: J3.1, L_Highdrive4_1.14
/PIEZO42-_2: J5.1, L_Highdrive4_2.14
/SC0_P: MUX2.5 (SC0), P0.4, R10.1
/SC0_Q: MUX1.5 (SC0), Q0.5, R27.1
/SC1_P: MUX2.7 (SC1), P1.4, R12.1
/SC1_Q: MUX1.7 (SC1), Q1.5, R29.1
/SC2_P: MUX2.9 (SC2), P2.4, R14.1
/SC2_Q: MUX1.9 (SC2), Q2.5, R31.1
/SC3_P: MUX2.11 (SC3), P3.4, R16.1
/SC3_Q: MUX1.11 (SC3), Q3.5, R33.1
/SC4_P: MUX2.14 (SC4), P4.4, R18.1
/SC4_Q: MUX1.14 (SC4), Q4.5, R35.1
/SC5_P: MUX2.16 (SC5), P5.4, R20.1
/SC5_Q: MUX1.16 (SC5), Q5.5, R37.1
/SC6_P: MUX2.18 (SC6), P6.4, R22.1
/SC6_Q: MUX1.18 (SC6), Q6.5, R39.1
/SC7_P: MUX2.20 (SC7), P7.4, R24.1
/SC7_Q: MUX1.20 (SC7), Q7.5, R41.1
/SCK: R-ESP32-C3.7, R-ESP32-C3.8, SPI_SD-Card_1.4
/SCL_3.3V: MUX1.22 (SCL), MUX2.22 (SCL), R-ESP32-C3.15, R-ESP32-C3.16, U3.5 (SCL_A)
/SCL_5V: L_Highdrive4_1.6, L_Highdrive4_2.6, U3.8 (SCL_B)
/SD0_P: MUX2.4 (SD0), P0.3, R11.1
/SD0_Q: MUX1.4 (SD0), Q0.2, R26.1
/SD1_P: MUX2.6 (SD1), P1.3, R13.1
/SD1_Q: MUX1.6 (SD1), Q1.2, R28.1
/SD2_P: MUX2.8 (SD2), P2.3, R15.1
/SD2_Q: MUX1.8 (SD2), Q2.2, R30.1
/SD3_P: MUX2.10 (SD3), P3.3, R17.1
/SD3_Q: MUX1.10 (SD3), Q3.2, R32.1
/SD4_P: MUX2.13 (SD4), P4.3, R19.1
/SD4_Q: MUX1.13 (SD4), Q4.2, R34.1
/SD5_P: MUX2.15 (SD5), P5.3, R21.1
/SD5_Q: MUX1.15 (SD5), Q5.2, R36.1
/SD6_P: MUX2.17 (SD6), P6.3, R23.1
/SD6_Q: MUX1.17 (SD6), Q6.2, R38.1
/SD7_P: MUX2.19 (SD7), P7.3, R25.1
/SD7_Q: MUX1.19 (SD7), Q7.2, R40.1
/SDA_3.3V: MUX1.23 (SDA), MUX2.23 (SDA), R-ESP32-C3.13, R-ESP32-C3.14, U3.4 (SDA_A)
/SDA_5V: L_Highdrive4_1.5, L_Highdrive4_2.5, U3.1 (SDA_B)
GNDREF: C1.2, C2.2, C3.2, C4.2, C5.2, C6.2, C7.2, C8.2, C9.2, C10.2, J1.2, J1.3, L_Highdrive4_1.1, L_Highdrive4_1.3, L_Highdrive4_1.4, L_Highdrive4_2.1, L_Highdrive4_2.4, MUX1.1 (A0), MUX1.2 (A1), MUX1.12 (GND), MUX2.1 (A0), MUX2.2 (A1), MUX2.12 (GND), MUX2.21 (A2), P0.1, P1.1, P2.1, P3.1, P4.1, P5.1, P6.1, P7.1, Q0.1, Q0.4, Q0.6, Q1.1, Q1.4, Q1.6, Q2.1, Q2.4, Q2.6, Q3.1, Q3.4, Q3.6, Q4.1, Q4.4, Q4.6, Q5.1, Q5.4, Q5.6, Q6.1, Q6.4, Q6.6, Q7.1, Q7.4, Q7.6, R-ESP32-C3.3, R-ESP32-C3.4, R_Highdrive4_1.2, R_Highdrive4_2.2, S1.5, SPI_SD-Card_1.6, U1.1 (GND), U2.1 (GND), U3.2 (GND)
unnamed: D1.2 (A), J1.1
unnamed: C1.1, D3.1 (K), Q8.3, U2.3 (VI)
unnamed: MUX1.3 (~RESET), R7.1
unnamed: MUX2.3 (~RESET), R8.1
unnamed: Q8.1, R5.1, S1.4
unnamed: R9.2, U3.6 (OE)
