marionas01/Global_Resist_Electronics/Honeywell_HSC_Pressure_Sensor/Honeywell_HSC_SMT.kicad_pcb

## KiCad design Honeywell_HSC_Pressure_Sensor/Honeywell_HSC_SMT.kicad_pcb (2026-08-07)

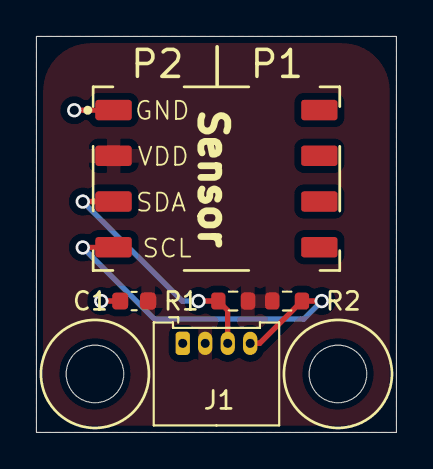
[picture p31: board Honeywell_HSC_SMT.kicad_pcb from above]

Board: 2 copper layers, 20.0 x 22.0 mm, 5 parts (0 on the bottom side), 4 nets.

Parts:
C1: 0.1uF; C_0603_1608Metric
J1: Conn_01x04; Molex_PicoBlade_53048-0410_1x04_P1.25mm_Horizontal
R1, R2: 10k; R_0603_1608Metric
Sensor: Honeywell_HSC_SMT

Connections:
/GND: C1.1, J1.1, Sensor.1 (GND)
/SCL: J1.4, R2.2, Sensor.4 (SCL)
/SDA: J1.3, R1.2, Sensor.3 (SDA)
/VDD: C1.2, J1.2, R1.1, R2.1, Sensor.2 (VDD)
