marionas01/Global_Resist_Electronics/Measurement_Board/Measurement_Board.kicad_pcb

## KiCad design Measurement_Board/Measurement_Board.kicad_pcb (2026-08-07)

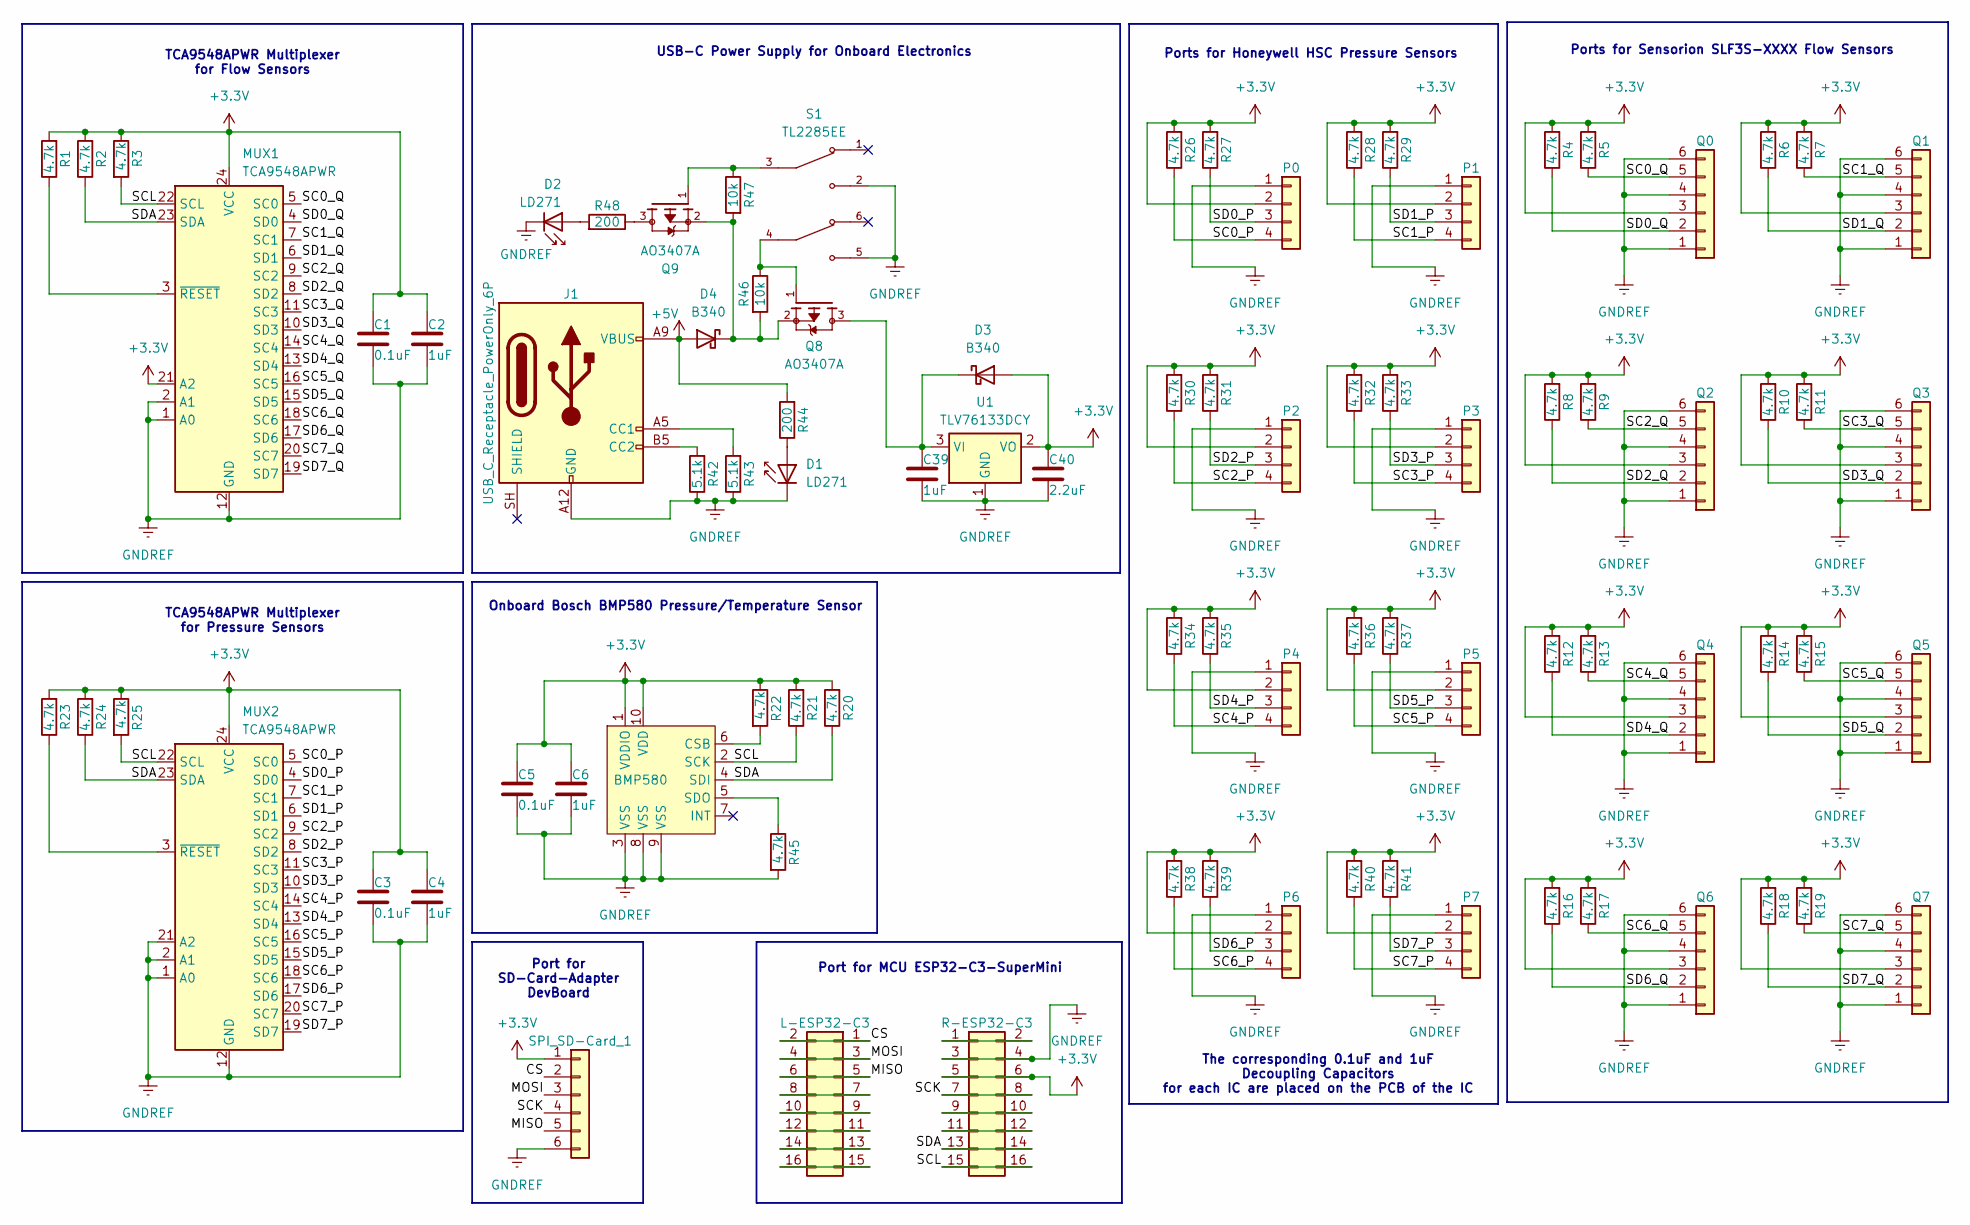
[picture p32: schematic Measurement_Board.kicad_sch, EvolChip Measurement Board]

Parts:
BMP580: BMP580
C1, C3, C5: 0.1uF; C_0603_1608Metric
C2, C4, C6: 1uF; C_0603_1608Metric
C39: 1uF; C_0805_2012Metric
C40: 2.2uF; C_0805_2012Metric
D1, D2: LD271; D_0603_1608Metric
D3, D4: B340; D_SMA
J1: USB_C_Receptacle_PowerOnly_6P; USB_C_Receptacle_GCT_USB4125-xx-x-0190_6P_TopMnt_Horizontal
L-ESP32-C3: Conn_02x08_Odd_Even; PinSocket_2x08_P2.54mm_Vertical
MUX1, MUX2: TCA9548APWR; TSSOP-24_4.4x7.8mm_P0.65mm
P0, P1, P2, P3, P4, P5, P6, P7: Conn_01x04; Molex_PicoBlade_53047-0410_1x04_P1.25mm_Vertical
Q0, Q1, Q2, Q3, Q4, Q5, Q6, Q7: Conn_01x06; Molex_PicoBlade_53047-0610_1x06_P1.25mm_Vertical
Q8, Q9: AO3407A; SOT95P280X125-3N; PARTREV 5
R1, R2, R3, R4, R5, R6, R7, R8, R9, R10, R11, R12, R13, R14, R15, R16, R17, R18, R19, R20, R21, R22, R23, R24, R25, R26, R27, R28, R29, R30, R31, R32, R33, R34, R35, R36, R37, R38, R39, R40, R41, R45: 4.7k; R_0603_1608Metric
R42, R43: 5.1k; R_0805_2012Metric
R44, R48: 200; R_0603_1608Metric
R46, R47: 10k; R_0805_2012Metric
R-ESP32-C3: Conn_02x08_Odd_Even; PinSocket_2x08_P2.54mm_Vertical
S1: TL2285EE; SW_TL2285EE; PARTREV B
SPI_SD-Card_1: Conn_01x06; PinSocket_1x06_P2.54mm_Vertical
U1: TLV76133DCY; SOT-223-3_TabPin2

Connections:
+3.3V: BMP580.1 (VDDIO), BMP580.10 (VDD), C1.1, C2.1, C3.1, C4.1, C5.1, C6.1, C40.1, D3.2 (A), MUX1.21 (A2), MUX1.24 (VCC), MUX2.24 (VCC), P0.2, P1.2, P2.2, P3.2, P4.2, P5.2, P6.2, P7.2, Q0.3, Q1.3, Q2.3, Q3.3, Q4.3, Q5.3, Q6.3, Q7.3, R1.2, R2.2, R3.1, R4.2, R5.2, R6.2, R7.2, R8.2, R9.2, R10.2, R11.2, R12.2, R13.2, R14.2, R15.2, R16.2, R17.2, R18.2, R19.2, R20.2, R21.2, R22.1, R23.2, R24.2, R25.1, R26.2, R27.2, R28.2, R29.2, R30.2, R31.2, R32.2, R33.2, R34.2, R35.2, R36.2, R37.2, R38.2, R39.2, R40.2, R41.2, R-ESP32-C3.5, R-ESP32-C3.6, SPI_SD-Card_1.1, U1.2 (VO)
+5V: D4.2 (A), J1.A9 (VBUS), J1.B9 (VBUS), R44.2
/CS: L-ESP32-C3.1, L-ESP32-C3.2, SPI_SD-Card_1.2
/MISO: L-ESP32-C3.5, L-ESP32-C3.6, SPI_SD-Card_1.5
/MOSI: L-ESP32-C3.3, L-ESP32-C3.4, SPI_SD-Card_1.3
/SC0_P: MUX2.5 (SC0), P0.4, R26.1
/SC0_Q: MUX1.5 (SC0), Q0.5, R5.1
/SC1_P: MUX2.7 (SC1), P1.4, R28.1
/SC1_Q: MUX1.7 (SC1), Q1.5, R7.1
/SC2_P: MUX2.9 (SC2), P2.4, R30.1
/SC2_Q: MUX1.9 (SC2), Q2.5, R9.1
/SC3_P: MUX2.11 (SC3), P3.4, R32.1
/SC3_Q: MUX1.11 (SC3), Q3.5, R11.1
/SC4_P: MUX2.14 (SC4), P4.4, R34.1
/SC4_Q: MUX1.14 (SC4), Q4.5, R13.1
/SC5_P: MUX2.16 (SC5), P5.4, R36.1
/SC5_Q: MUX1.16 (SC5), Q5.5, R15.1
/SC6_P: MUX2.18 (SC6), P6.4, R38.1
/SC6_Q: MUX1.18 (SC6), Q6.5, R17.1
/SC7_P: MUX2.20 (SC7), P7.4, R40.1
/SC7_Q: MUX1.20 (SC7), Q7.5, R19.1
/SCK: R-ESP32-C3.7, R-ESP32-C3.8, SPI_SD-Card_1.4
/SCL: BMP580.2 (SCK), MUX1.22 (SCL), MUX2.22 (SCL), R3.2, R21.1, R25.2, R-ESP32-C3.15, R-ESP32-C3.16
/SD0_P: MUX2.4 (SD0), P0.3, R27.1
/SD0_Q: MUX1.4 (SD0), Q0.2, R4.1
/SD1_P: MUX2.6 (SD1), P1.3, R29.1
/SD1_Q: MUX1.6 (SD1), Q1.2, R6.1
/SD2_P: MUX2.8 (SD2), P2.3, R31.1
/SD2_Q: MUX1.8 (SD2), Q2.2, R8.1
/SD3_P: MUX2.10 (SD3), P3.3, R33.1
/SD3_Q: MUX1.10 (SD3), Q3.2, R10.1
/SD4_P: MUX2.13 (SD4), P4.3, R35.1
/SD4_Q: MUX1.13 (SD4), Q4.2, R12.1
/SD5_P: MUX2.15 (SD5), P5.3, R37.1
/SD5_Q: MUX1.15 (SD5), Q5.2, R14.1
/SD6_P: MUX2.17 (SD6), P6.3, R39.1
/SD6_Q: MUX1.17 (SD6), Q6.2, R16.1
/SD7_P: MUX2.19 (SD7), P7.3, R41.1
/SD7_Q: MUX1.19 (SD7), Q7.2, R18.1
/SDA: BMP580.4 (SDI), MUX1.23 (SDA), MUX2.23 (SDA), R2.1, R20.1, R24.1, R-ESP32-C3.13, R-ESP32-C3.14
GNDREF: BMP580.3 (VSS), BMP580.8 (VSS), BMP580.9 (VSS), C1.2, C2.2, C3.2, C4.2, C5.2, C6.2, C39.2, C40.2, D1.1 (K), D2.1 (K), J1.A12 (GND), J1.B12 (GND), MUX1.1 (A0), MUX1.2 (A1), MUX1.12 (GND), MUX2.1 (A0), MUX2.2 (A1), MUX2.12 (GND), MUX2.21 (A2), P0.1, P1.1, P2.1, P3.1, P4.1, P5.1, P6.1, P7.1, Q0.1, Q0.4, Q0.6, Q1.1, Q1.4, Q1.6, Q2.1, Q2.4, Q2.6, Q3.1, Q3.4, Q3.6, Q4.1, Q4.4, Q4.6, Q5.1, Q5.4, Q5.6, Q6.1, Q6.4, Q6.6, Q7.1, Q7.4, Q7.6, R42.1, R43.1, R45.2, R-ESP32-C3.3, R-ESP32-C3.4, S1.2, S1.5, SPI_SD-Card_1.6, U1.1 (GND)
unnamed: BMP580.6 (CSB), R22.2
unnamed: BMP580.5 (SDO), R45.1
unnamed: D1.2 (A), R44.1
unnamed: D2.2 (A), R48.2
unnamed: C39.1, D3.1 (K), Q8.3, U1.3 (VI)
unnamed: D4.1 (K), Q8.2, Q9.2, R46.2, R47.2
unnamed: J1.A5 (CC1), R43.2
unnamed: J1.B5 (CC2), R42.2
unnamed: L-ESP32-C3.7, L-ESP32-C3.8
unnamed: L-ESP32-C3.9, L-ESP32-C3.10
unnamed: L-ESP32-C3.11, L-ESP32-C3.12
unnamed: L-ESP32-C3.13, L-ESP32-C3.14
unnamed: L-ESP32-C3.15, L-ESP32-C3.16
unnamed: MUX1.3 (~RESET), R1.1
unnamed: MUX2.3 (~RESET), R23.1
unnamed: Q8.1, R46.1, S1.4
unnamed: Q9.1, R47.1, S1.3
unnamed: Q9.3, R48.1
unnamed: R-ESP32-C3.1, R-ESP32-C3.2
unnamed: R-ESP32-C3.9, R-ESP32-C3.10
unnamed: R-ESP32-C3.11, R-ESP32-C3.12

Notes on the sheet:
Port for MCU ESP32-C3-SuperMini
The corresponding 0.1uF and 1uF Decoupling Capacitors for each IC are placed on the PCB of the IC
Onboard Bosch BMP580 Pressure/Temperature Sensor
USB-C Power Supply for Onboard Electronics
TCA9548APWR Multiplexer for Flow Sensors
TCA9548APWR Multiplexer for Pressure Sensors
Ports for Sensorion SLF3S-XXXX Flow Sensors
Ports for Honeywell HSC Pressure Sensors
Port for SD-Card-Adapter DevBoard

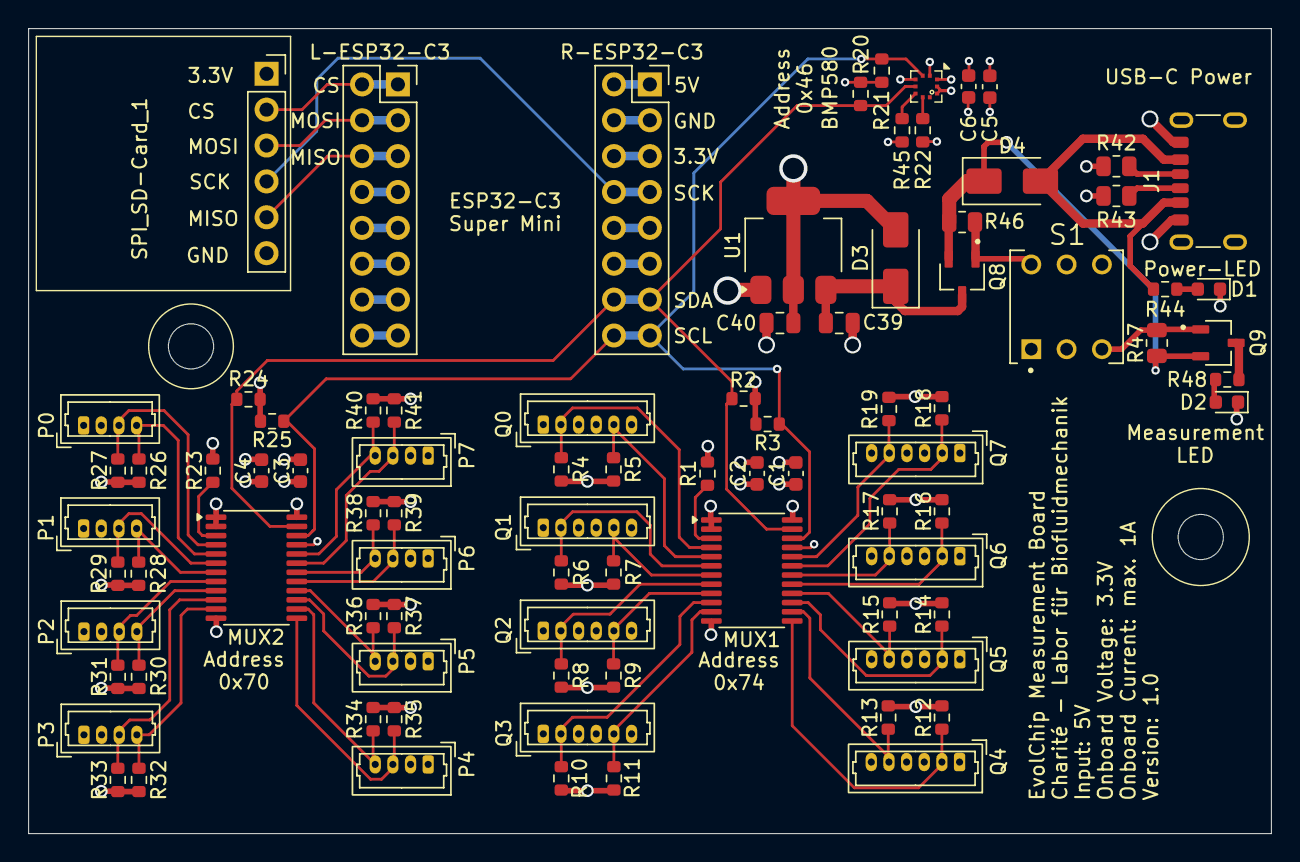
[picture p33: board Measurement_Board.kicad_pcb from above]

Board: 4 copper layers, 88.0 x 57.0 mm, 87 parts (0 on the bottom side), 62 nets.
