marionas01/Global_Resist_Electronics/(commit log)

2026-08-07 First Push
    [Honeywell_HSC_SMT-B_Cu.gbl, Honeywell_HSC_SMT-B_Mask.gbs, Honeywell_HSC_SMT-B_Paste.gbp, Honeywell_HSC_SMT-B_Silkscreen.gbo, Honeywell_HSC_SMT-Edge_Cuts.gm1, Honeywell_HSC_SMT-F_Cu.gtl, Honeywell_HSC_SMT-F_Mask.gts, Honeywell_HSC_SMT-F_Paste.gtp]
2026-08-07 New Boards added
    [AO3407A.step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]
2026-08-07 Folders cleaned
    [Control_Board.kicad_pcb, Measurement_Board.csv]
2026-08-07 Honeywell_HSC_Pressure_Sensor break out board: changed 4.7kOhm to 10kOhm
    [Honeywell_HSC_SMT-B_Cu.gbl, Honeywell_HSC_SMT-B_Mask.gbs, Honeywell_HSC_SMT-B_Paste.gbp, Honeywell_HSC_SMT-B_Silkscreen.gbo, Honeywell_HSC_SMT-Edge_Cuts.gm1, Honeywell_HSC_SMT-F_Cu.gtl, Honeywell_HSC_SMT-F_Mask.gts, Honeywell_HSC_SMT-F_Paste.gtp]
2026-09-08 CAD added
    [Asm.SLDASM, Case.SLDPRT, Case.STEP, Control_Board.kicad_pcb, Cover.SLDPRT, Cover.STEP, Display_Cover_Test.SLDPRT, Display_Cover_Test.STEP]
2026-09-10 Case and Cover CAD modfied to make it thinner
    [Asm.SLDASM, Case.SLDPRT, Cover.SLDPRT]
2026-09-11 Pump Control added
2026-09-17 CAD modified
    [Asm.SLDASM, Case.SLDPRT, Cover.SLDPRT, Mounting Frame.SLDPRT, Mounting Frame.STEP, PCB.SLDPRT, PCB.step, SLF3xMountingClamp_3D-CAD.SLDPRT]
2026-09-28 Cover Changed
    [Asm.SLDASM, Case.SLDPRT, Cover.SLDPRT]
2026-09-30 Flow Sensor Evaluation
    [Flowsensor_Kalibrierung.xlsx, Flowsensor_Vergleich.xlsx, flowlog_027.csv, flowlog_028.csv, flowlog_029.csv, flowlog_031.csv, flowlog_032.csv, flowlog_034.csv]
2026-10-01 smol Updates
    [Asm.SLDASM, Cover.SLDPRT, SLF3xMountingClamp_3D-CAD.SLDPRT, Sensirion_Liquid_Flow_Software_SLF3S-1300F_CAD-Model_D1.SLDPRT]
2026-10-14 New Calibration Data
2026-10-30 Update GUI with min to hour button on x-axis
2026-11-11 New CAD Update
